gavinslim/skittle_sorter/demo/PXL_20210930_054513089.jpg

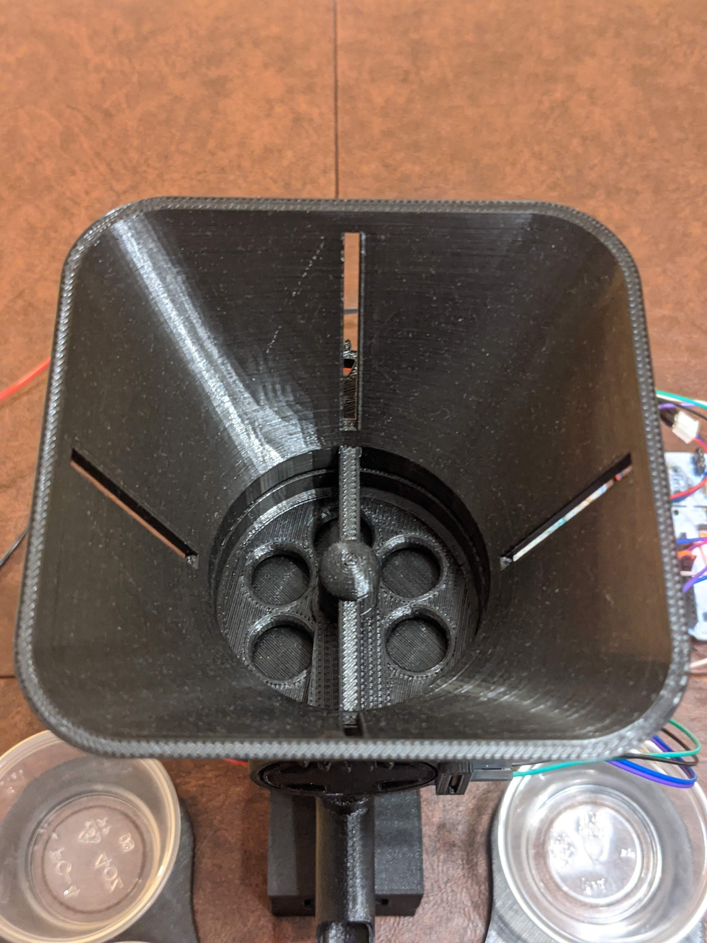
demo/PXL_20210930_054513089.jpg
