gavinslim/skittle_sorter/demo/PXL_20210930_054607322.jpg

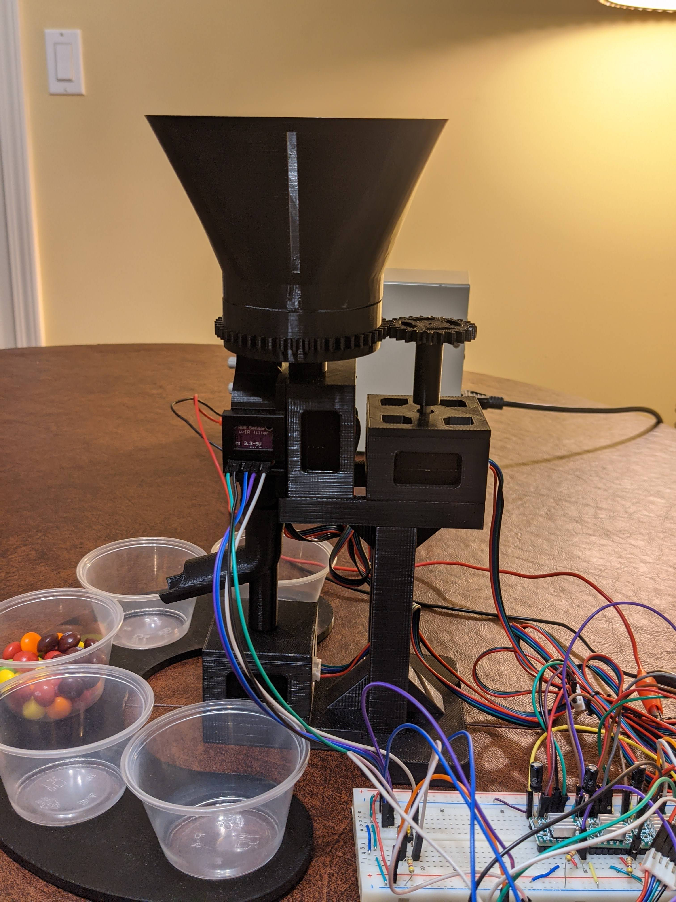
demo/PXL_20210930_054607322.jpg
