gavinslim/skittle_sorter/demo/PXL_20210930_054610583.jpg

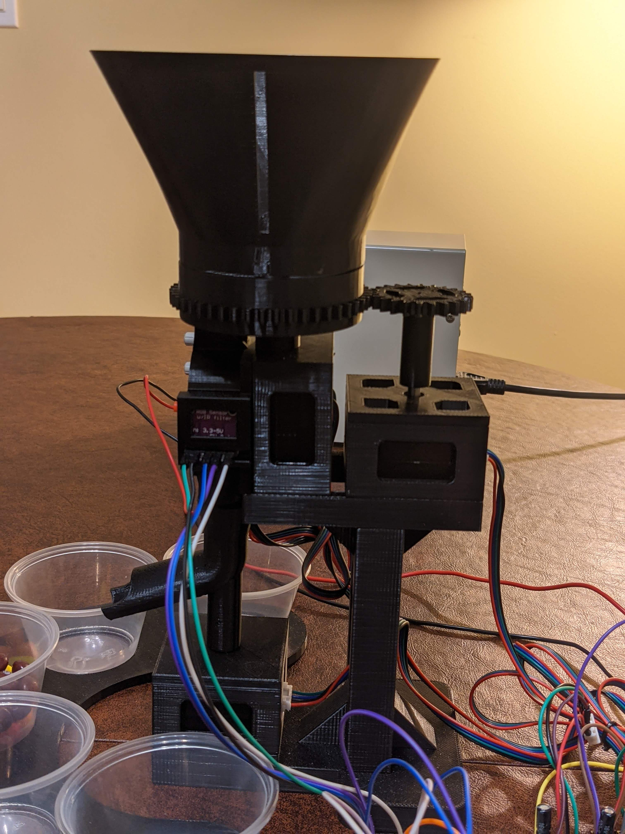
demo/PXL_20210930_054610583.jpg
