gavinslim/skittle_sorter/demo/PXL_20210930_054615046.jpg

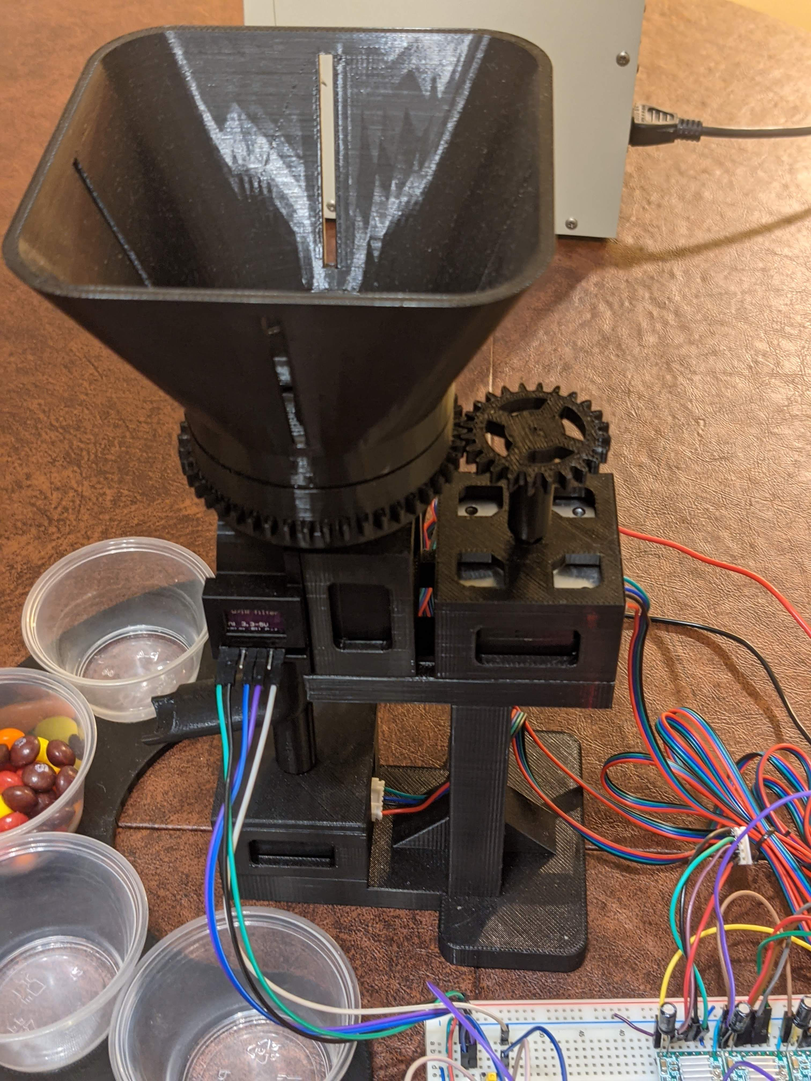
demo/PXL_20210930_054615046.jpg
