gavinslim/skittle_sorter/demo/PXL_20210930_054642197.jpg

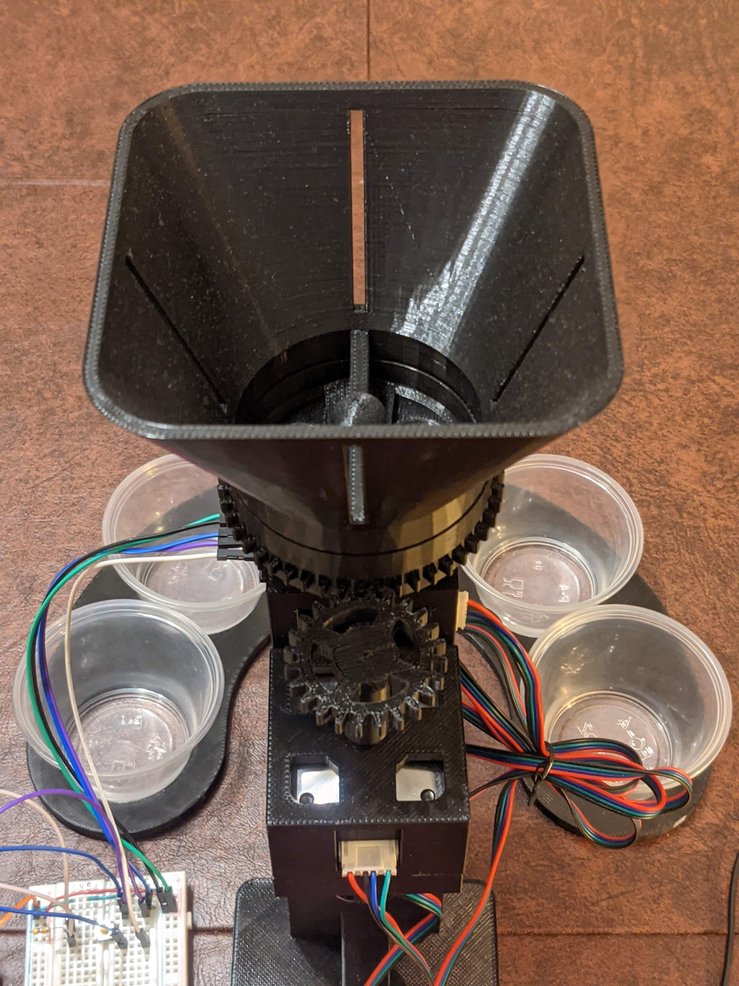
demo/PXL_20210930_054642197.jpg
