gavinslim/skittle_sorter/demo/PXL_20210930_054646798.jpg

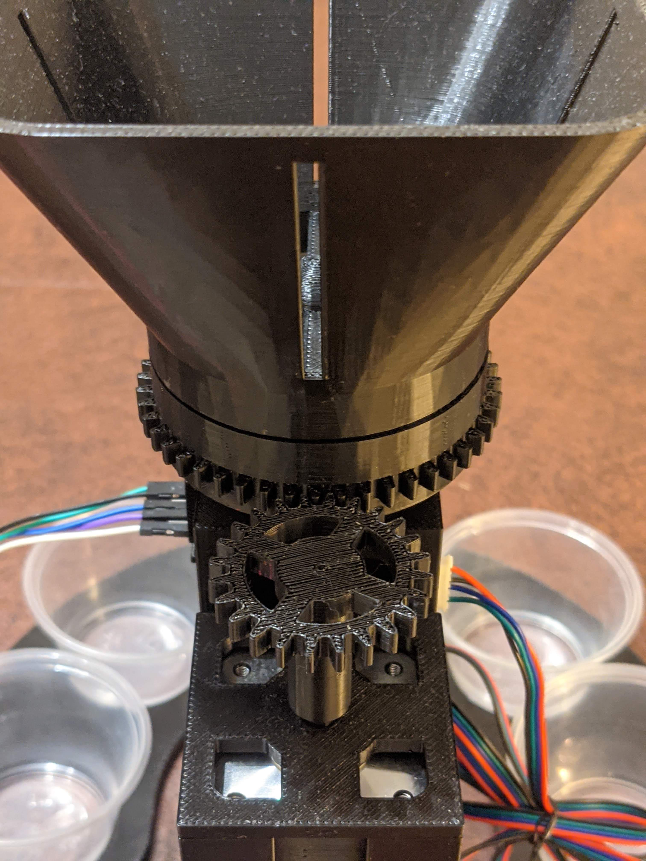
demo/PXL_20210930_054646798.jpg
