gavinslim/skittle_sorter/demo/solidwork/revolver_orderly.PNG

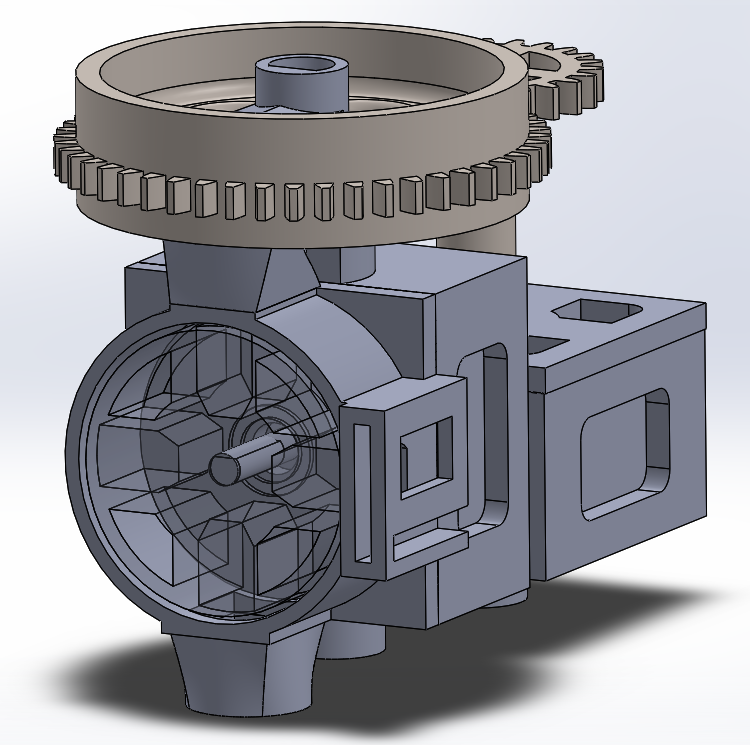
demo/solidwork/revolver_orderly.PNG
