gavinslim/skittle_sorter/Src/main.c

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

/* Includes ------------------------------------------------------------------*/
#include "main.h"

/* USER CODE BEGIN Includes */
#include <stdio.h> //UART
#include <stdint.h>
#include "string.h"

/* USER CODE END Includes */

I2C_HandleTypeDef hi2c1;

TIM_HandleTypeDef htim1;
TIM_HandleTypeDef htim5;

UART_HandleTypeDef huart2;

/* USER CODE BEGIN PV */
uint8_t id;
RetVal ret;
RGBC raw_color;
DWORD color;
ByteStruct atime;
int led_on = 0;
/* USER CODE END PV */

void SystemClock_Config(void);
static void MX_GPIO_Init(void);
static void MX_USART2_UART_Init(void);
static void MX_I2C1_Init(void);
static void MX_TIM1_Init(void);
static void MX_TIM5_Init(void);
/* USER CODE BEGIN PFP */
void transmit_uart(char *string);
void int2uart(uint16_t input);
/* USER CODE END PFP */

/**
  * @brief  The application entry point.
  * @retval int
  */
int main(void)
{
  /* USER CODE BEGIN 1 */

	// PB14 - Interrupt input pin (To enable/disable TCS34725 LED)

  /* USER CODE END 1 */

  /* MCU Configuration--------------------------------------------------------*/

  /* Reset of all peripherals, Initializes the Flash interface and the Systick. */
  HAL_Init();

  /* Configure the system clock */
  SystemClock_Config();

  /* Initialize all configured peripherals */
  MX_GPIO_Init();
  MX_USART2_UART_Init();
  MX_I2C1_Init();
  MX_TIM1_Init();
  MX_TIM5_Init();
  /* USER CODE BEGIN 2 */
  HAL_TIM_PWM_Start(&htim5, TIM_CHANNEL_1);
  /* USER CODE END 2 */

  /* Infinite loop */
  /* USER CODE BEGIN WHILE */

  // Power On Sensor (Set PON bit)
  if (power_on(hi2c1) != HAL_OK) {
  	transmit_uart("ERROR: Failed to power on.\r\n");
  	return FAIL;
  } else {
  	transmit_uart("PASS: Power on sensor. \r\n");
  }

  HAL_Delay(3);
  if (start(hi2c1) != HAL_OK) {
  	transmit_uart("ERROR: Failed to start sensor in RGBC mode.\r\n");
  	return FAIL;
  } else {
  	transmit_uart("PASS: Sensor started in RGBC mode. \r\n");
  }

  // Check ID
  ByteStruct id = check_id(hi2c1);
  if (id.status != HAL_OK) {
  	transmit_uart("ERROR: Failed to check ID.\r\n");
  	return FAIL;
  } else {
  	transmit_uart("PASS: ID = ");
  	int2uart(id.val);
  	transmit_uart("\r\n");
  }

  // Check status
  ByteStruct stat = check_status(hi2c1);
  if (stat.status != HAL_OK) {
  	transmit_uart("ERROR: Failed to check status. \r\n");
  	return FAIL;
  } else {
  	transmit_uart("PASS: Status = ");
  	int2uart(stat.val);
  	transmit_uart("\r\n");
  }

  set_atime(hi2c1, INTEGRATION_TIME_154MS);

  ByteStruct atime = check_atime(hi2c1);
  if (atime.status != HAL_OK) {
  	transmit_uart("ERROR: Failed to check ATIME. \r\n");
  	return FAIL;
  } else {
  	transmit_uart("PASS: ATIME = ");
  	int2uart(atime.val);
  	transmit_uart("\r\n");
  }

  BYTE gain = check_gain(hi2c1);
  transmit_uart("PASS: Gain = ");
  int2uart(gain);
  transmit_uart("\r\n");

  Eflavour flavour;

  // Initiate variables
  int num_empty = 0;
  int max_retries = 7;
  int curr_degrees = 90;

  int order_delay = 25;
  int read_delay = 10;

  while (1)
  {
    /* USER CODE END WHILE */

    /* USER CODE BEGIN 3 */
  	if (led_on == 1) {

			// Check color
  		color = read_sensor(hi2c1, atime, read_delay, order_delay);
			flavour = check_colour_side(color);

			// If flavour is unknown, which indicates
			if (flavour == UNKNOWN) {
				num_empty++;
			} else {
				num_empty = 0;
			}

			// Print out
			/*
			BYTE red = color >> 16;
			BYTE green = (color >> 8) & 0xFF;
			BYTE blue = color & 0xFF;

			transmit_uart("R: ");
			int2uart(red);
			transmit_uart(" | G: ");
			int2uart(green);
			transmit_uart(" | B: ");
			int2uart(blue);
			transmit_uart(" >>> ");
			*/

			switch (flavour) {
			case UNKNOWN:
				transmit_uart(" Empty\r\n");
				break;
			case LEMON:
				transmit_uart(" Lemon\r\n");
				break;
			case GREEN_APPLE:
				transmit_uart(" Green Apple\r\n");
				break;
			case STRAWBERRY:
				transmit_uart(" Strawberry\r\n");
				break;
			case ORANGE:
				transmit_uart(" Orange\r\n");
				break;
			case GRAPE:
				transmit_uart(" Grape\r\n");
				break;
			default:
				transmit_uart(" Default\r\n");
				break;
			}

			// Rotate Distributor
			curr_degrees = rotate_distributor(flavour, curr_degrees, order_delay);

			// Rotate Orderly motor
  		rotate_orderly(order_delay);

			// Rotate Revolver motor by 60 degrees at each interval
  		rotate_revolver(order_delay);

			// If no skittles detected 6 times, then no more skittles in hopper. End process.
			if (num_empty >= max_retries) {
				transmit_uart("\r\n NO MORE SKITTLES DETECTED. END.");
				return 0;
			}
  	}
  }
  /* USER CODE END 3 */
}

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
/* USER CODE BEGIN 4 */
void transmit_uart(char *string){
	uint8_t len = strlen(string);
	HAL_UART_Transmit(&huart2, (uint8_t*) string, len, 200);
}


void int2uart(uint16_t input){
	char text[20];
	sprintf(text, "%d", input);
	char *p = text;
	transmit_uart(p);
	//transmit_uart("\r\n");
}

void HAL_GPIO_EXTI_Callback(uint16_t GPIO_Pin)
{
  /* Prevent unused argument(s) compilation warning */
  UNUSED(GPIO_Pin);
  /* NOTE: This function Should not be modified, when the callback is needed,
           the HAL_GPIO_EXTI_Callback could be implemented in the user file
   */
	// Toggle color sensor LED
  HAL_GPIO_TogglePin(LED_EN_PORT, LED_EN_PIN);
	transmit_uart("TOGGLED\r\n");
	led_on = !led_on;

	// Switch bounce
	for (uint32_t i=0; i < 100000; i++);
}
/* USER CODE END 4 */
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
