gavinslim/skittle_sorter/(commit log)

2021-05-21 Init I2C communication with TCS34725
2021-05-22 - Add global_var source and header file for initializing struct RetVal - Add function for checking device status
2021-05-25 - Add functions for TCS34725 (check red channel and power on/off)
2021-08-31 Stable version - Working color sensor - Working motor distribution
2021-10-21 Minor comment and variable fix
    [main.c]
