gavinslim/skittle_sorter/demo/PXL_20210930_054521102.jpg

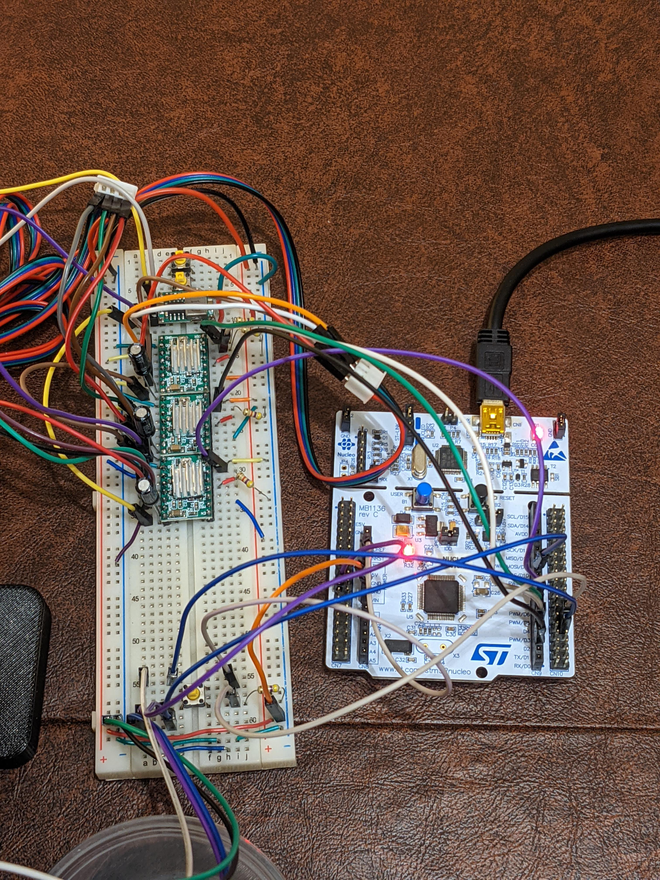
demo/PXL_20210930_054521102.jpg
