gavinslim/skittle_sorter/demo/PXL_20210930_054328688.jpg

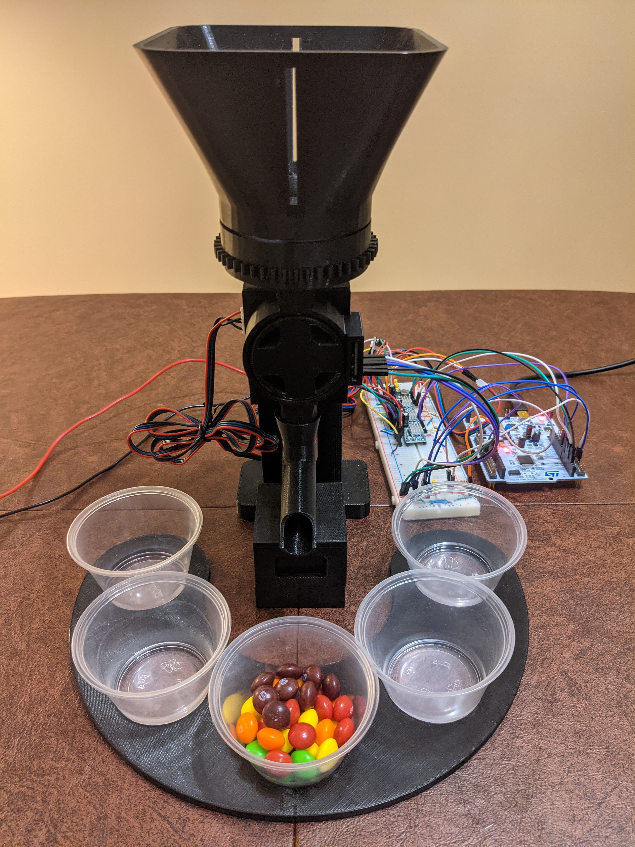
[picture p1: demo/PXL_20210930_054328688.jpg]
demo/PXL_20210930_054328688.jpg
